sajmo0n/Time_Sampling_Oscilloscope/Project Outputs for Time_Sampling_Oscilloscope/BOM/Bill of Materials-Time_Sampling_Oscilloscope(Basic Assembly).xlsx

Description | Designator | Footprint | LibRef | Quantity | MPN
Non-polarised capacitor | C1_1, C1_2, C4_1, C4_2, C11, C26, C29, C33 | CAPC0603X90N | CC0603_1UF_16V_10%_X7R | 8 | CL10B105KO8NNNC
Non-polarised capacitor | C2_1, C2_2, C5_1, C5_2, C8, C9, C13, C15, C18, C19, C22, C23, C27, C28, C31, C32, C34, C35_1, C35_2, C36_1, C36_2, C37_1, C37_2, C38_1, C38_2, C40 | CAPC0603X90N | CC0603_100NF_16V_10%_X7R | 26 | VJ0603Y104KXJCW1BC
Non-polarised capacitor | C3_1, C3_2, C6_1, C6_2 | CAPC0603X90N | CC0603_100PF_50V_5%_X7R | 4 | 06035C101JAT2A
Non-polarised capacitor | C7, C10, C12, C16, C17, C20 | CAPC0603X90N | CC0603_2U2F_16V_10%_X7R | 6 | GRM188Z71C225KE43D
Non-polarised capacitor | C21, C24 | CAPC0603X90N | CC0603_4U7F_16V_10%_X7R | 2 | GRM188Z71C475KE21D
Non-polarised capacitor | C30 | CAPC0603X90N | CC0603_10UF_25V_10%_X7R | 1 | GRM188R61E106KA73D
Fuse; Very Fast Acting; 1.5A; 125VAC, 63VDC; SMD; | F1 | FUSE1206 | C1Q 1 | 1 | C1Q 1.5
Coaxial Connectors SMA, Edge Mount, Female Receptacle, 0.062" PCB Mount, Gold | J1, J2, J5, J6 | CONSMA020.062-G | CONSMA020.062-G | 4 | CONSMA020.062-G
Coaxial Connectors VERTICAL PCB JACK GOLD PLATED BRASS | J3_1, J3_2, J3_3, J4_1, J4_2, J4_3 | 901-144-8RFX | 901-144-8RFX | 6 | 901-144-8RFX
4mm Jack 90deg PCB Mounted Insulated Socket Red | J7 | 5710500-Deltron | 571-0500 | 1 | 571-0500
4mm Jack 90deg PCB Mounted Insulated Socket Black | J8 | 5710100-Deltron | 571-0100 | 1 | 571-0100
Ferrite Bead | L1_1, L1_2, L2_1, L2_2, L3, L4_1, L4_2, L5, L6_1, L6_2, L7_1, L7_2, L8 | INDC0603X90N | FB0603_120R@100MHZ_2A | 13 | BLM18PG121SN1D
SMD mono-color Chip LED, Green, 0603 | LD1, LD2, LD3, LD4 | LED_0603X60N | LED_0603_V_GREEN | 4 | HSME-C191
WR-PHD SMT Angled Dual Pin Header, 2.54mm, 2x6 | P2, P3 | WURTH_610112249121 | WURTH_610112249121 | 2 | WURTH_610112249121
General Purpose Thick Film Chip Resistor | R2_1, R22, R34_2 | RESC0402X40N | R0402_49R9_0.0625W_100PPM | 3 | RC0402FR-0749R9L
General Purpose Thick Film Chip Resistor | R5_1, R5_2, R6_1, R6_2, R21, R27, R35, R38, R40 | RESC0402X40N | R0402_0R_JUMPER | 9 | CRCW04020000Z0EDC
General Purpose Thick Film Chip Resistor | R12, R13, R14, R17, R18 | RESC0603X60N | R0603_27R_0.1W_100PPM | 5 | WF06P270JTL
General Purpose Thick Film Chip Resistor | R15, R16 | RESC0603X60N | R0603_10K_0.1W_100PPM | 2 | CQ03SAF1002T5E
General Purpose Thick Film Chip Resistor | R23 | RESC0603X60N | R0603_1K_0.1W_100PPM | 1 | CQ03SAF1001T5E
General Purpose Thick Film Chip Resistor | R24, R25, R26 | RESC0603X60N | R0603_100R_0.1W_100PPM | 3 | 0603SAF1000T5E
General Purpose Thick Film Chip Resistor | R28_1, R28_2, R30_1, R30_2 | RESC0603X60N | R0603_100k_0.1W_25PPM | 4 | RT0603BRD07100KL
General Purpose Thick Film Chip Resistor | R29_1, R29_2, R31_1, R31_2, R32_1, R32_2, R33_1, R33_2 | RESC0603X60N | R0603_10k_0.1W_25PPM | 8 | RT0603BRD0710KL
General Purpose Thick Film Chip Resistor | R43_1, R43_2, R43_3, R44_1, R44_2, R44_3, R48_1, R48_2, R48_3, R49_1, R49_2, R49_3 | RESC0402X40N | R0402_1R43_0.0625W_100PPM | 12 | CRCW04021R43FKED
General Purpose Thick Film Chip Resistor | R45_1, R45_2, R45_3, R50_1, R50_2, R50_3 | RESC0402X40N | R0402_845R_0.0625W_100PPM | 6 | RC0402FR-07845RL
General Purpose Thick Film Chip Resistor | R46_1, R46_2, R46_3, R51_1, R51_2, R51_3 | RESC0402X40N | R0402_53R6_0.0625W_100PPM | 6 | RC0402FR-0753R6L
30V P-Channel MOSFET | T1 | SOT23-3 | AO3401A | 1 | AO3401A
Transistor: N-MOSFET; unipolar; 30V; 2.9A; 0.9W; SOT23 | T2, T3 | SOT23-3 | AO3406 | 2 | AO3406
Signal Conditioning 50 ohm 2 terminal Power Splitter | U1 | PS1608GT2R50T1 | PS1608GT2-R50-T1 | 1 | PS1608GT2-R50-T1
225-ps High-Speed Comparator with LVDS Outputs | U2_1, U2_2 | WSON50P200X200X80-9N | TLV3801 | 2 | TLV3801DSG
Ultralow Noise, 200 mA Linear Regulator, 2.5V out | U3 | SOT23-5 | ADM7160AUJZ-2.5 | 1 | ADM7160AUJZ-2.5
Switched Capacitor Inverter, Input Voltage: 2.7 V to 5.5 V, 200-mA Output Current | U4 | SOT23-6 | LM2776 | 1 | LM2776DBV
LDO Voltage Regulators -30V, 200mA, low noise, Linear Reg, 2.5V | U5 | SOT23-5 | ADP7182AUJZ-2.5 | 1 | ADP7182AUJZ-2.5
AD5623RBRMZ-3, Dual 12-/14-/16-Bit nanoDAC with 5 ppm/°C On-Chip Reference, 10-Pin MSOP | U6 | MSOP50P490X110-10N | AD5623RBRMZ-3 | 1 | AD5623RBRMZ-3
3.3V, 500 mA, Ultralow Noise, High PSRR,Fast Transient Response CMOS LDO, FIXED, LFCSP-8 | U7 | LFCSP50P300X300X80-9N-D | ADM7170ACPZ-3.3 | 1 | ADM7170ACPZ-3.3-R7
Precision Low Drift Low Noise Buffered Reference | U8 | MSOP65P490X110-8N | LTC6652BHMS8-1.25 | 1 | LTC6652BHMS8-1.25#PBF
SINGLE INVERTER GATE | U9 | SOT23-5 | SN74LVC1G04MDBVREP | 1 | SN74LVC1G04MDBVREP
VS = 1.8 V (±0.9 V) up to 5.5 V (±2.75 V), 350kHz, 2-?V VOS, 0.02-?V/°C, 17-?A, , Zero-Drift Series | U10_1, U10_2, U11_1, U11_2 | SOT23-5 | TLV333IDBV | 4 | TLV333IDBV
ADN4661BRZ, Single, 3 V, CMOS, LVDS, High Speed Differential Driver | U12 | SOIC-8 | ADN4661BRZ | 1 | ADN4661BRZ
Overvoltage Protection Controller, 2.5V to 5.5V Operation, Reverse Voltage Protection | U13 | SC70-8 | LTC4360ISC8-2 | 1 | LTC4360ISC8-2#TRMPBF
