sajmo0n/Time_Sampling_Oscilloscope/Project Outputs for Time_Sampling_Oscilloscope/SCHEMATICS/Time_Sampling_Oscilloscope.PDF

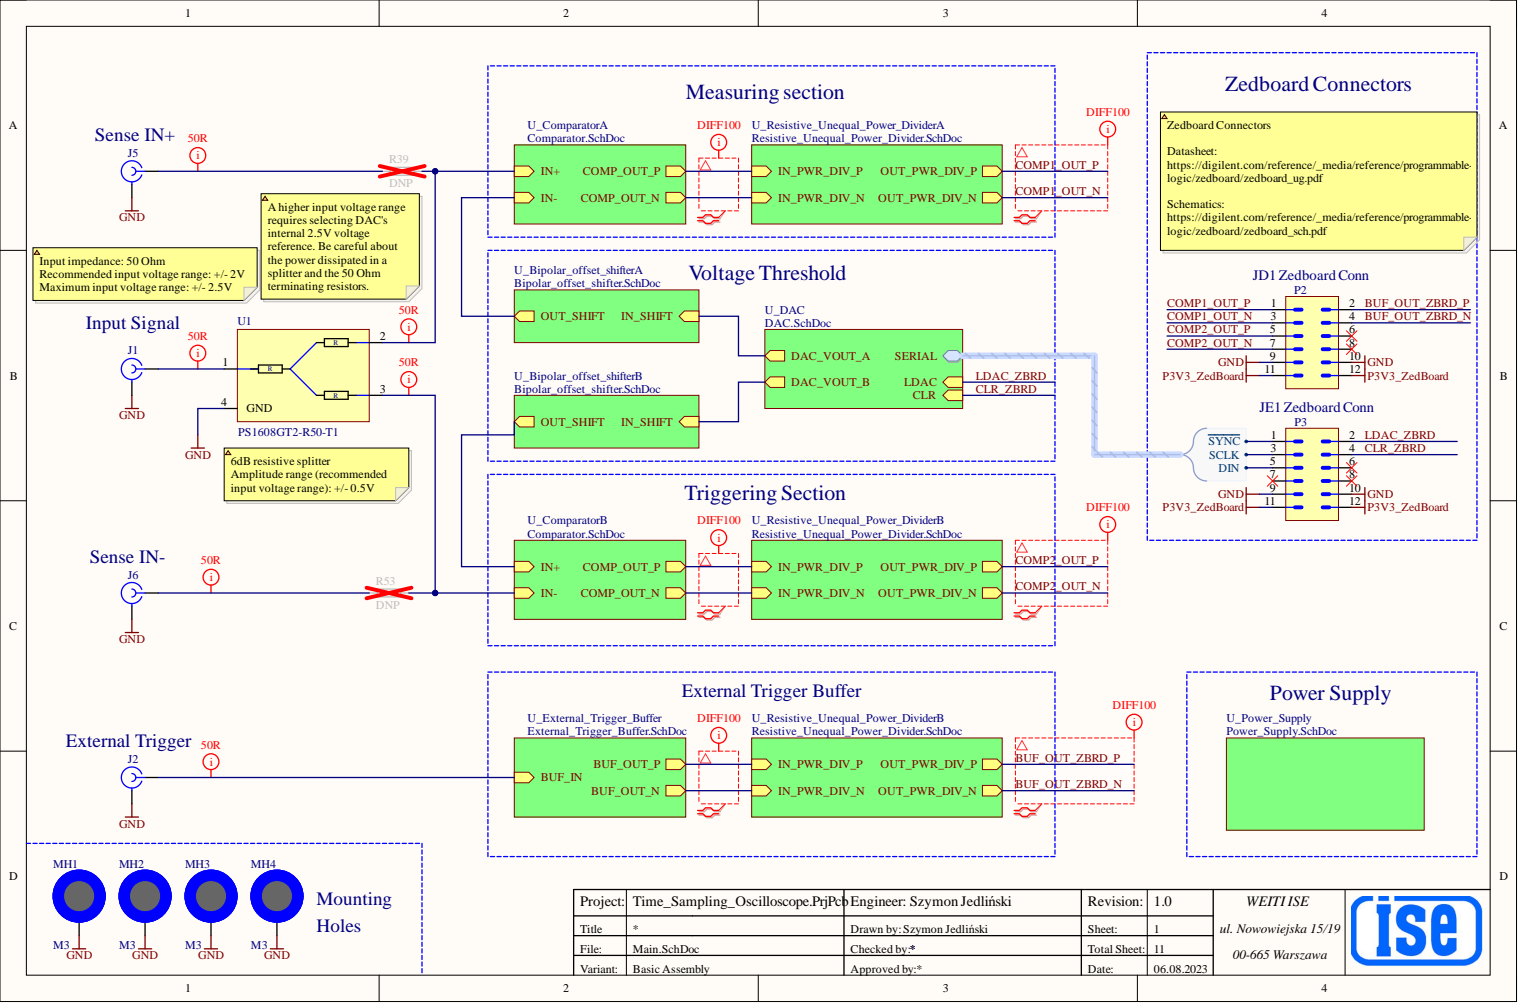
[picture p1: page 1]

T i tl e | * | Draw n Szymo Jed ń ki | Sheet
Fi : | Mai n.Sch D o c | Checked | To tal Sheet

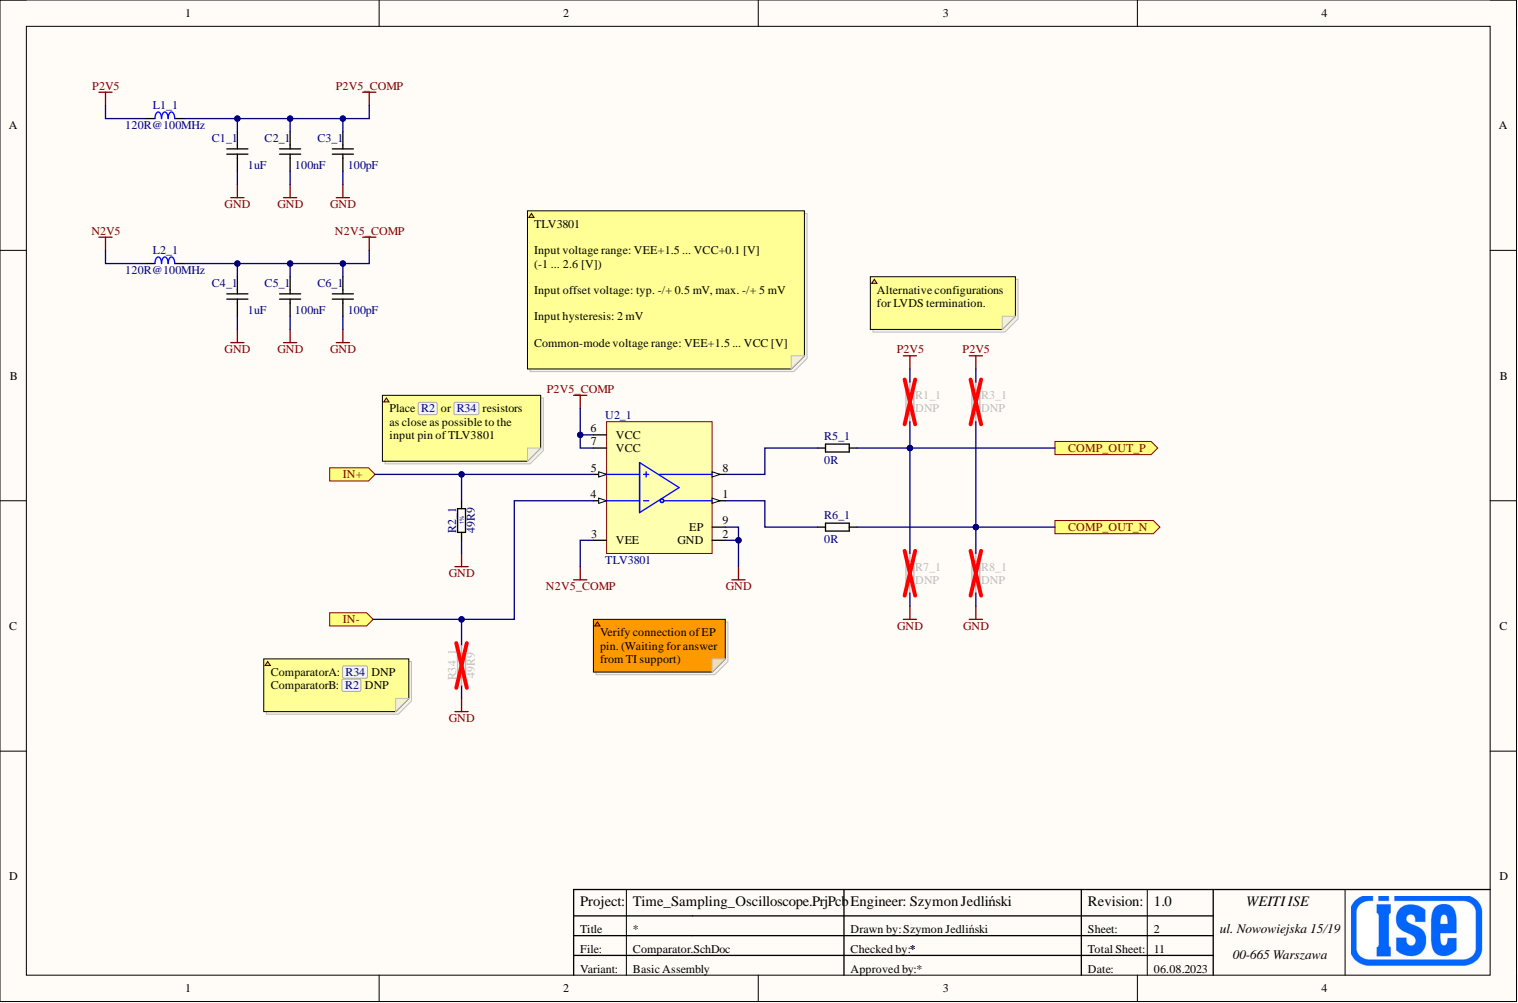
[picture p2: page 2]

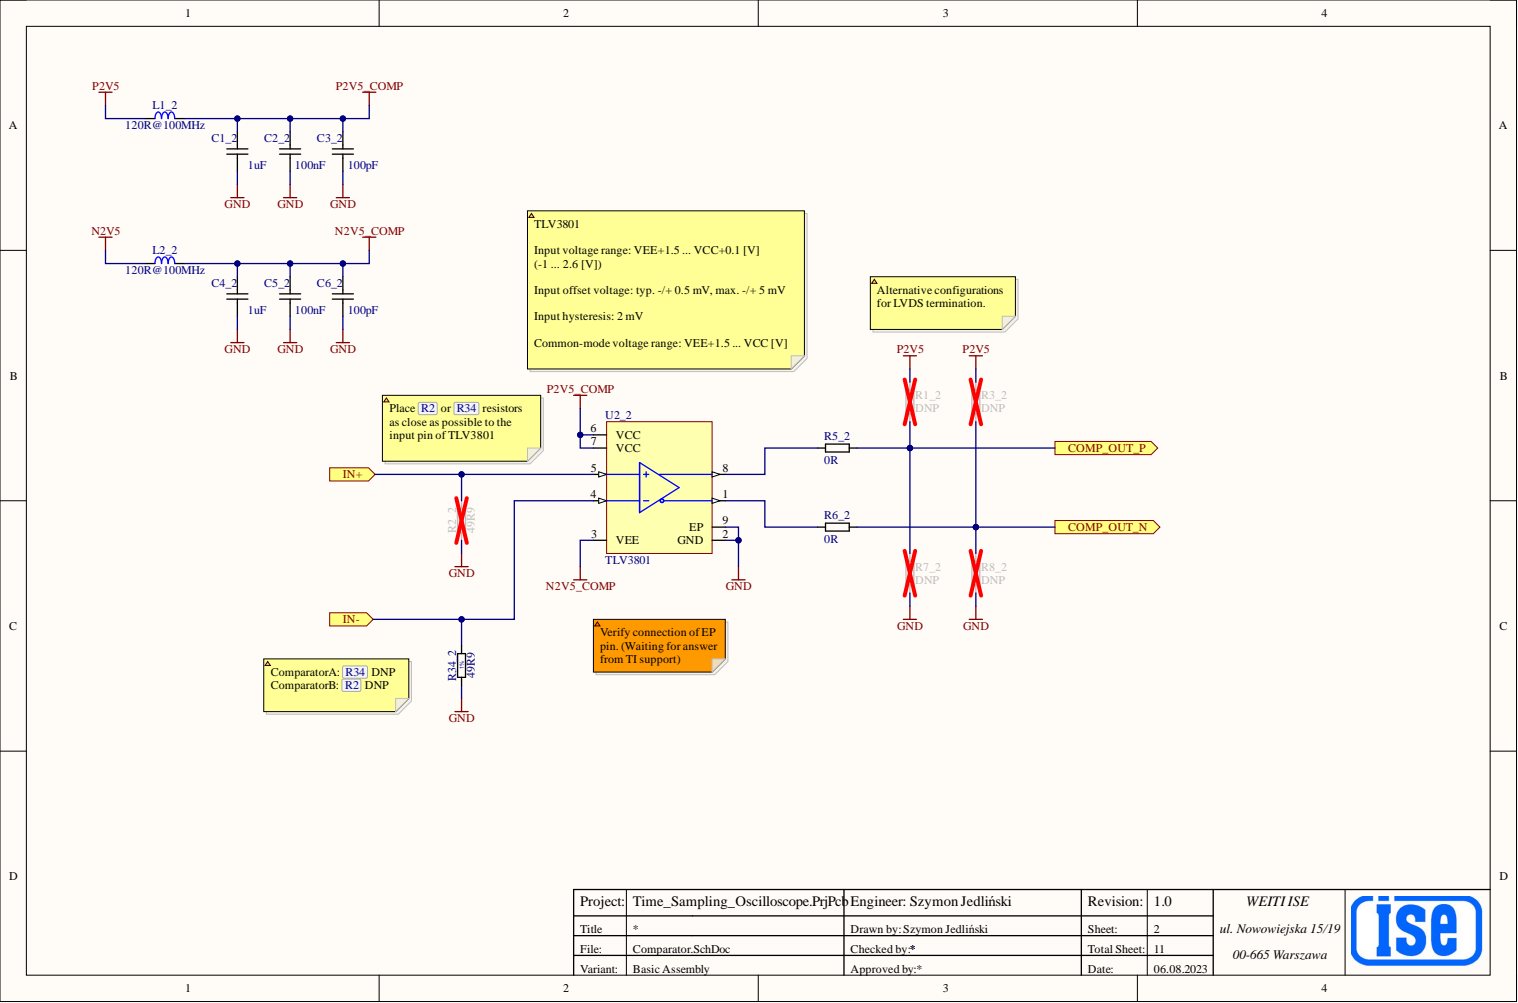
[picture p3: page 3]

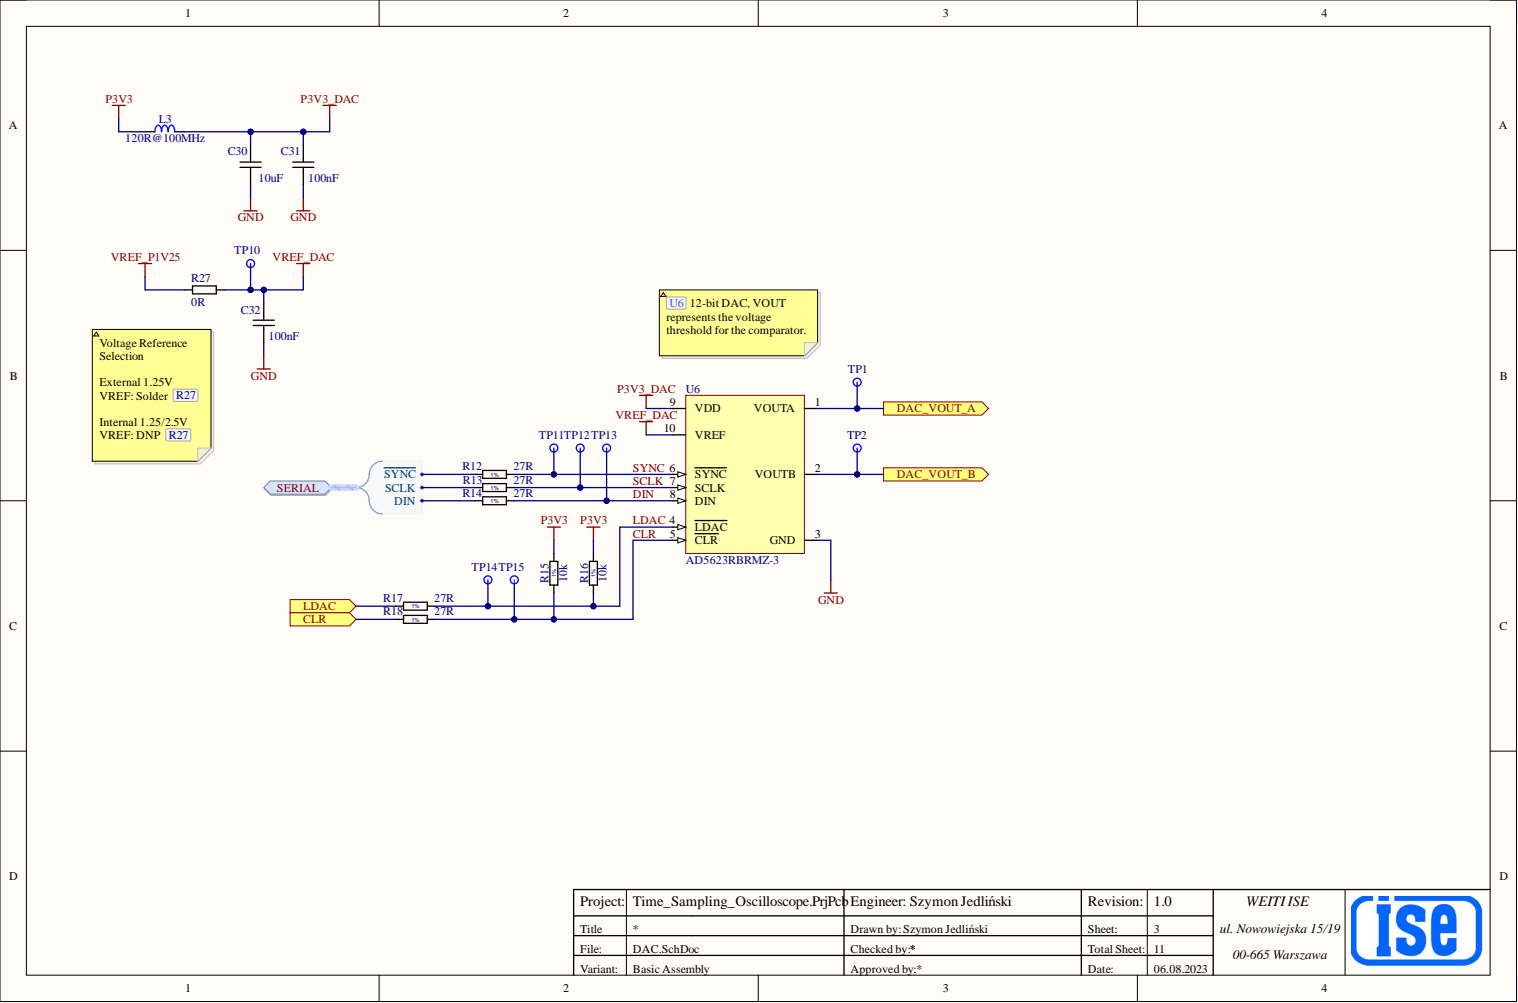
[picture p4: page 4]

U6 12-bit DAC, VOUT
represents the voltage
threshold for the comparator.

1% | SCLK | DIN 8 SCLK 7 SYNC 6

1% | DIN

Title | | Drawn by: Szymon Jedliński | Sheet:
File: | DAC.SchDoc | Checked by: | Total Sheet:

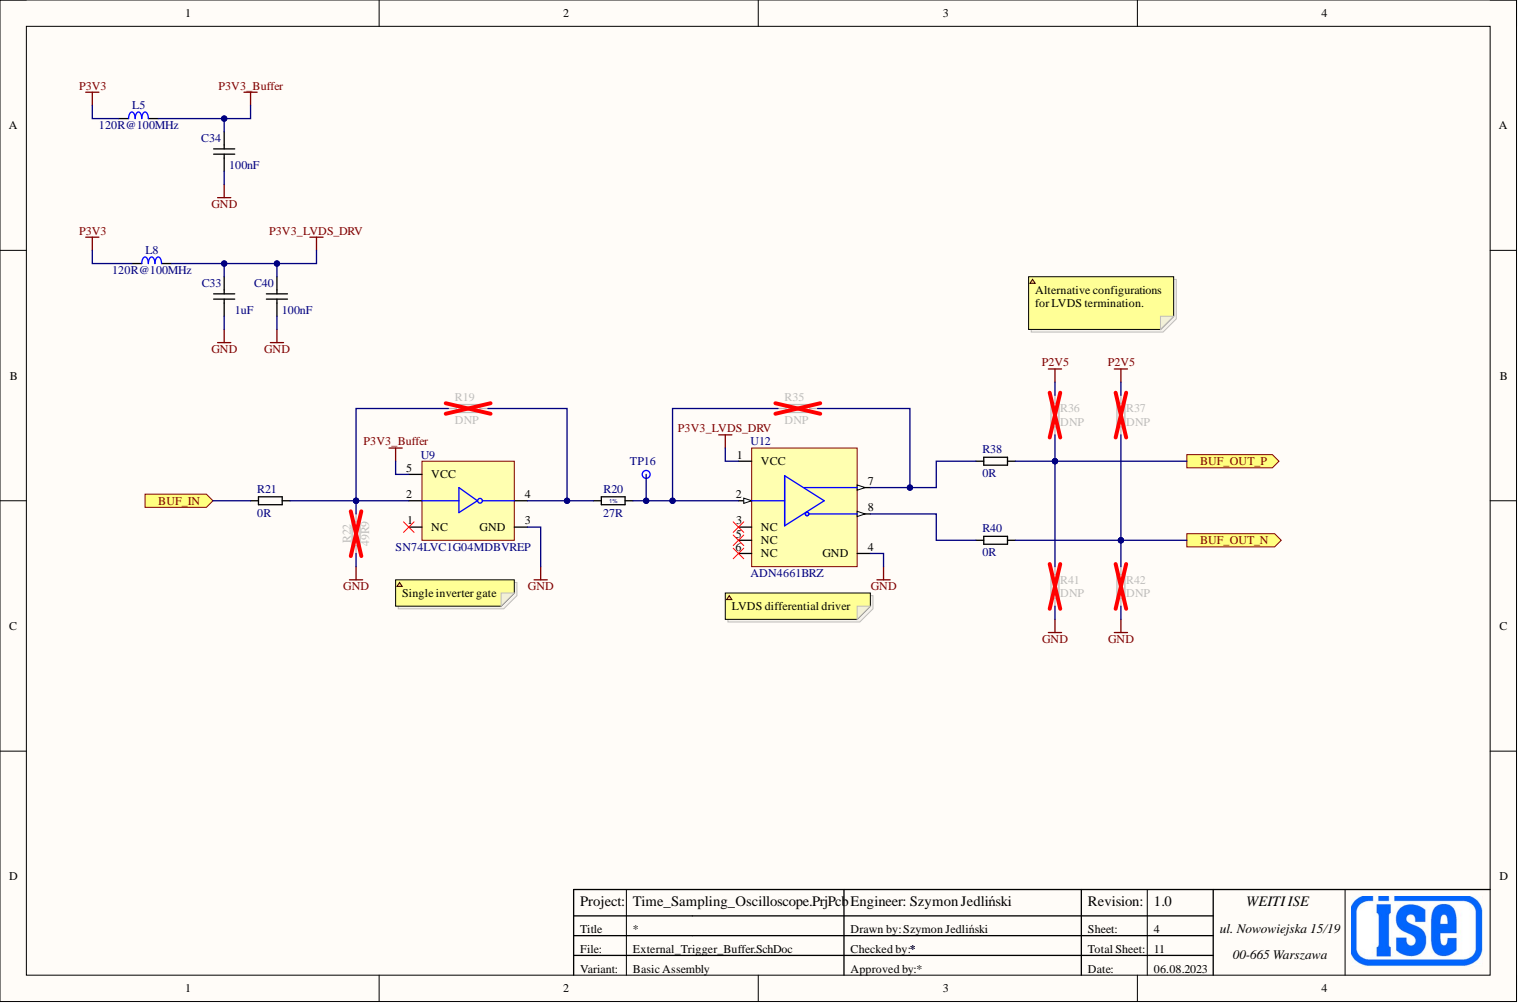
[picture p5: page 5]

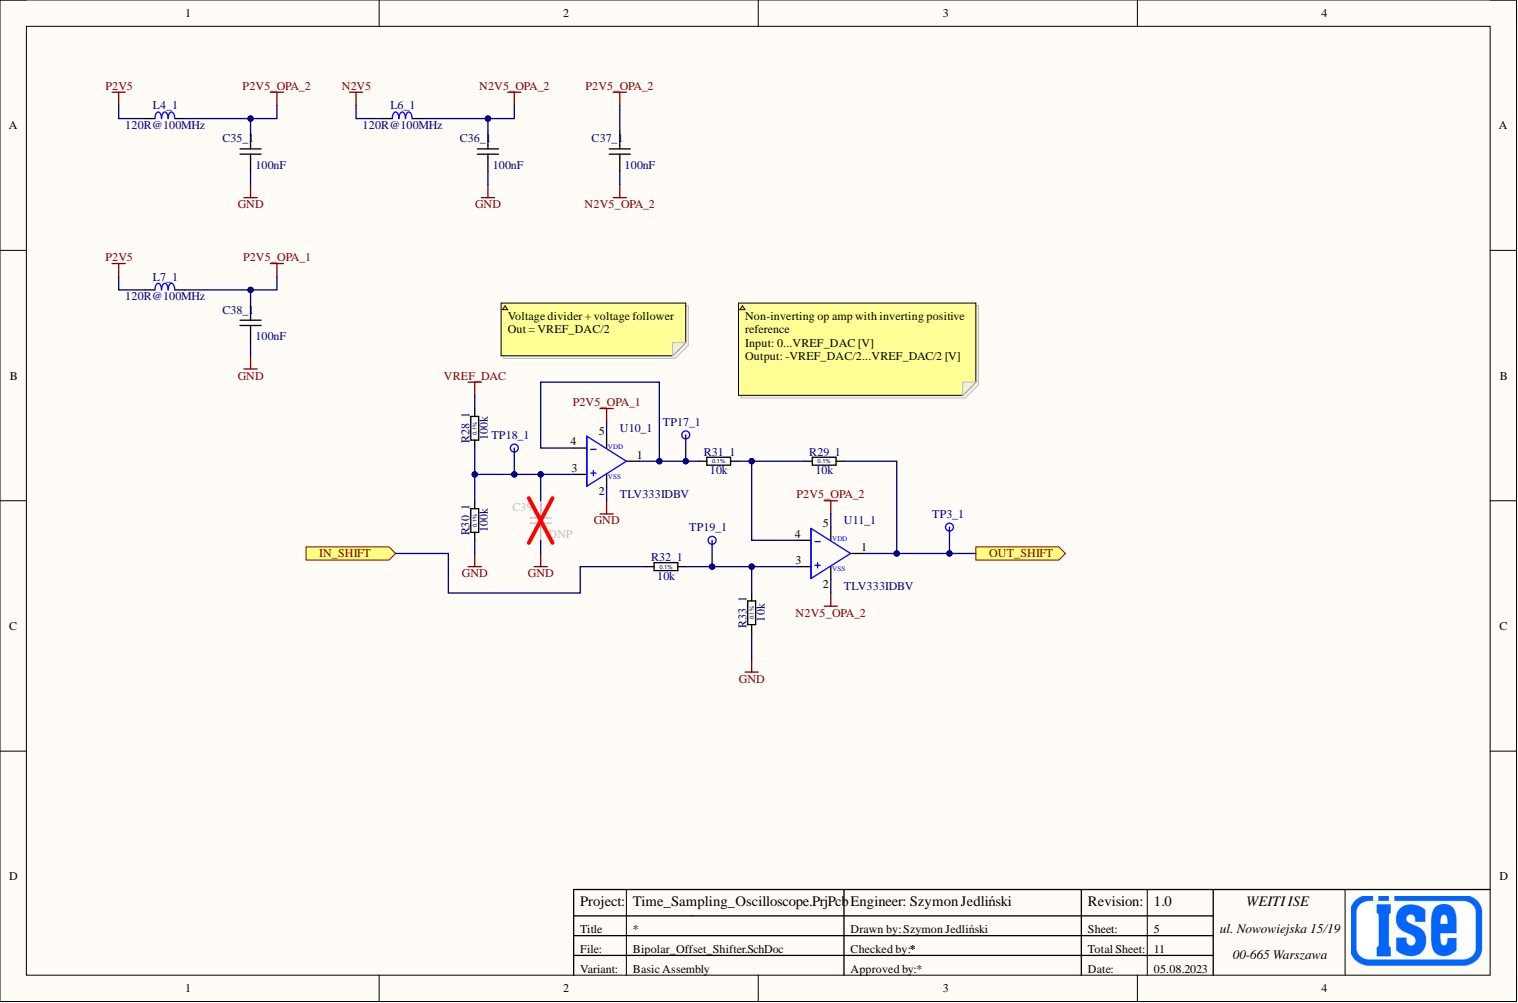
[picture p6: page 6]

Voltage divider + voltage follower
Out = VREF_DAC/2

Non-inverting op amp with inverting positive
reference
Input: 0...VREF_DAC [V]
Output: -VREF_DAC/2...VREF_DAC/2 [V]

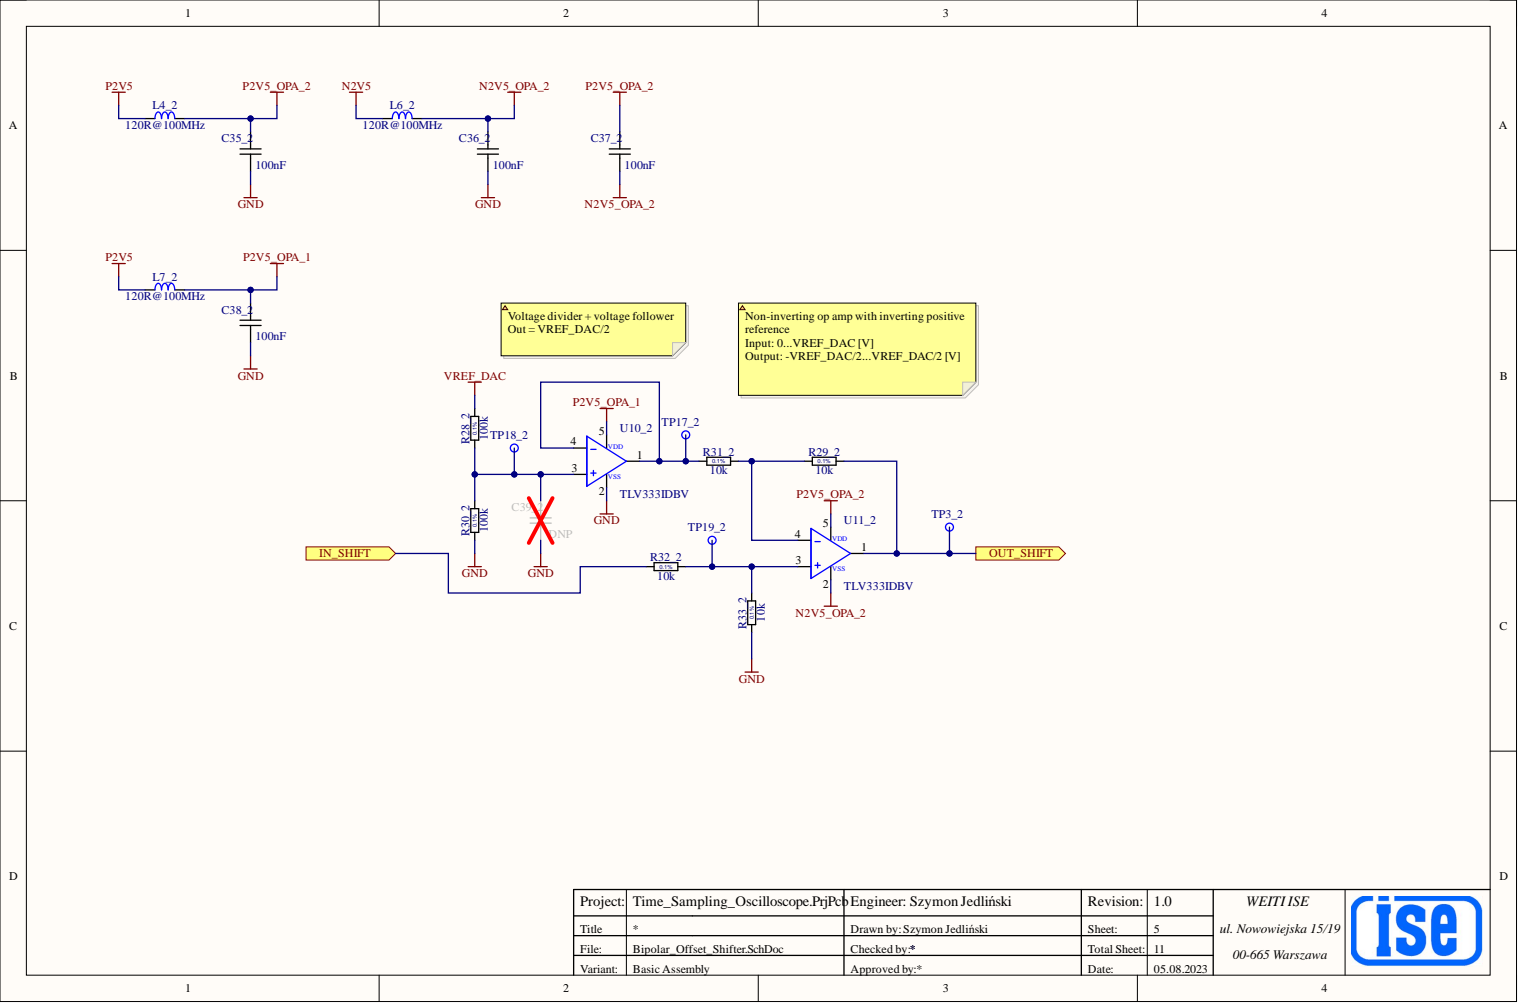
[picture p7: page 7]

Voltage divider + voltage follower
Out = VREF_DAC/2

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

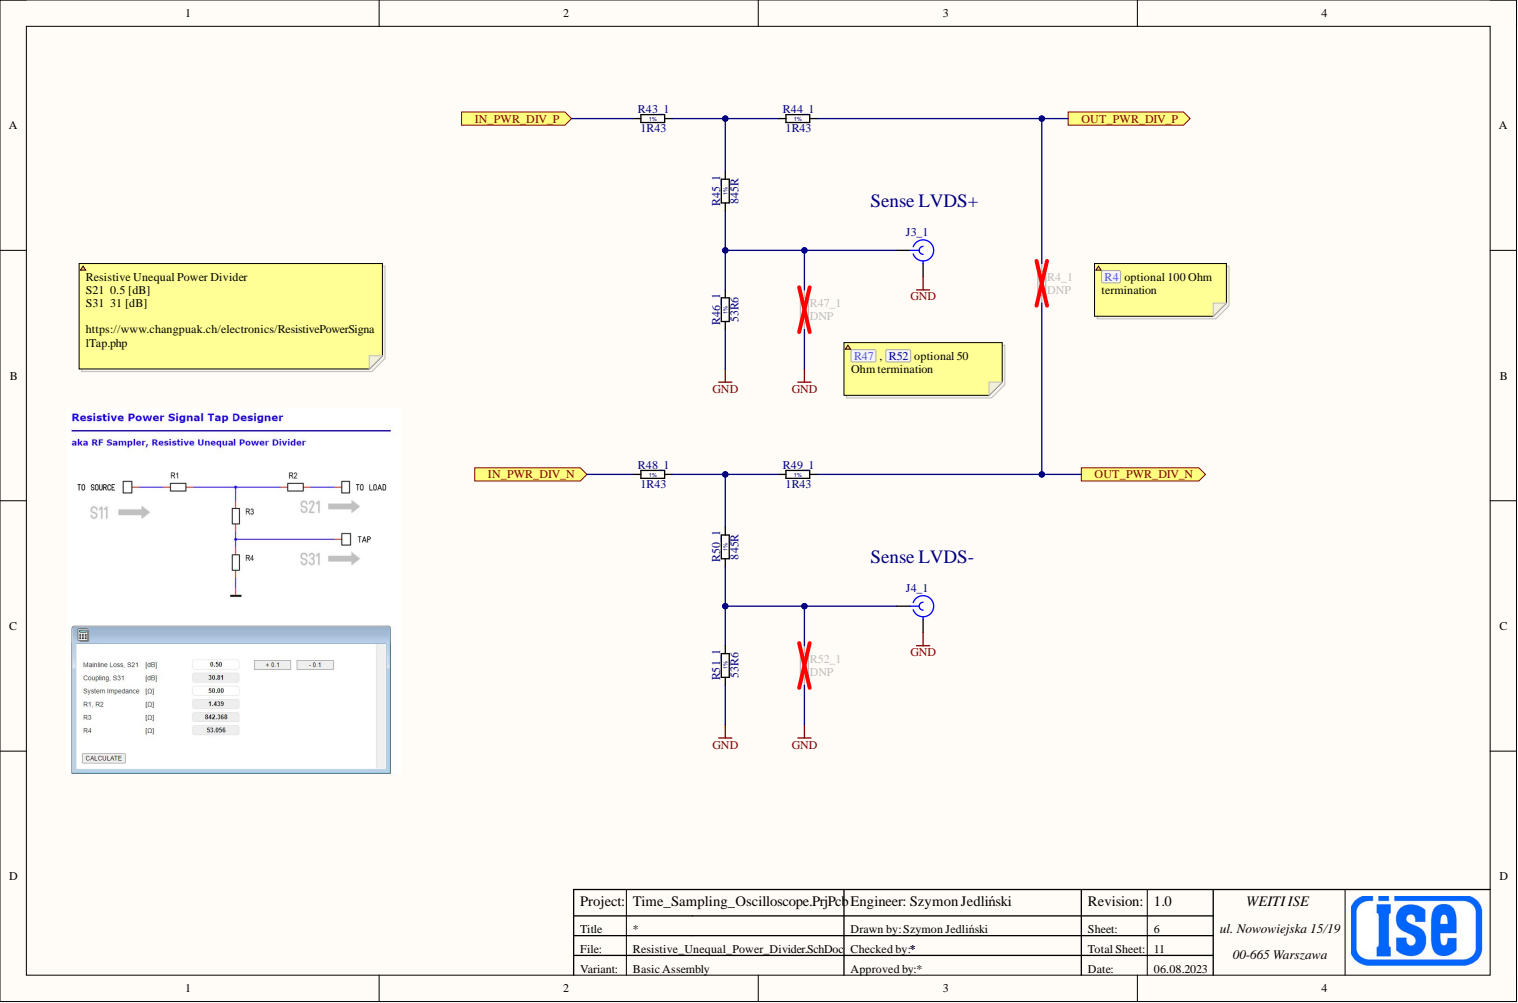
[picture p8: page 8]

Resistive Unequal Power Divider

https://www.changpuak.ch/electronics/ResistivePowerSigna
lTap.php

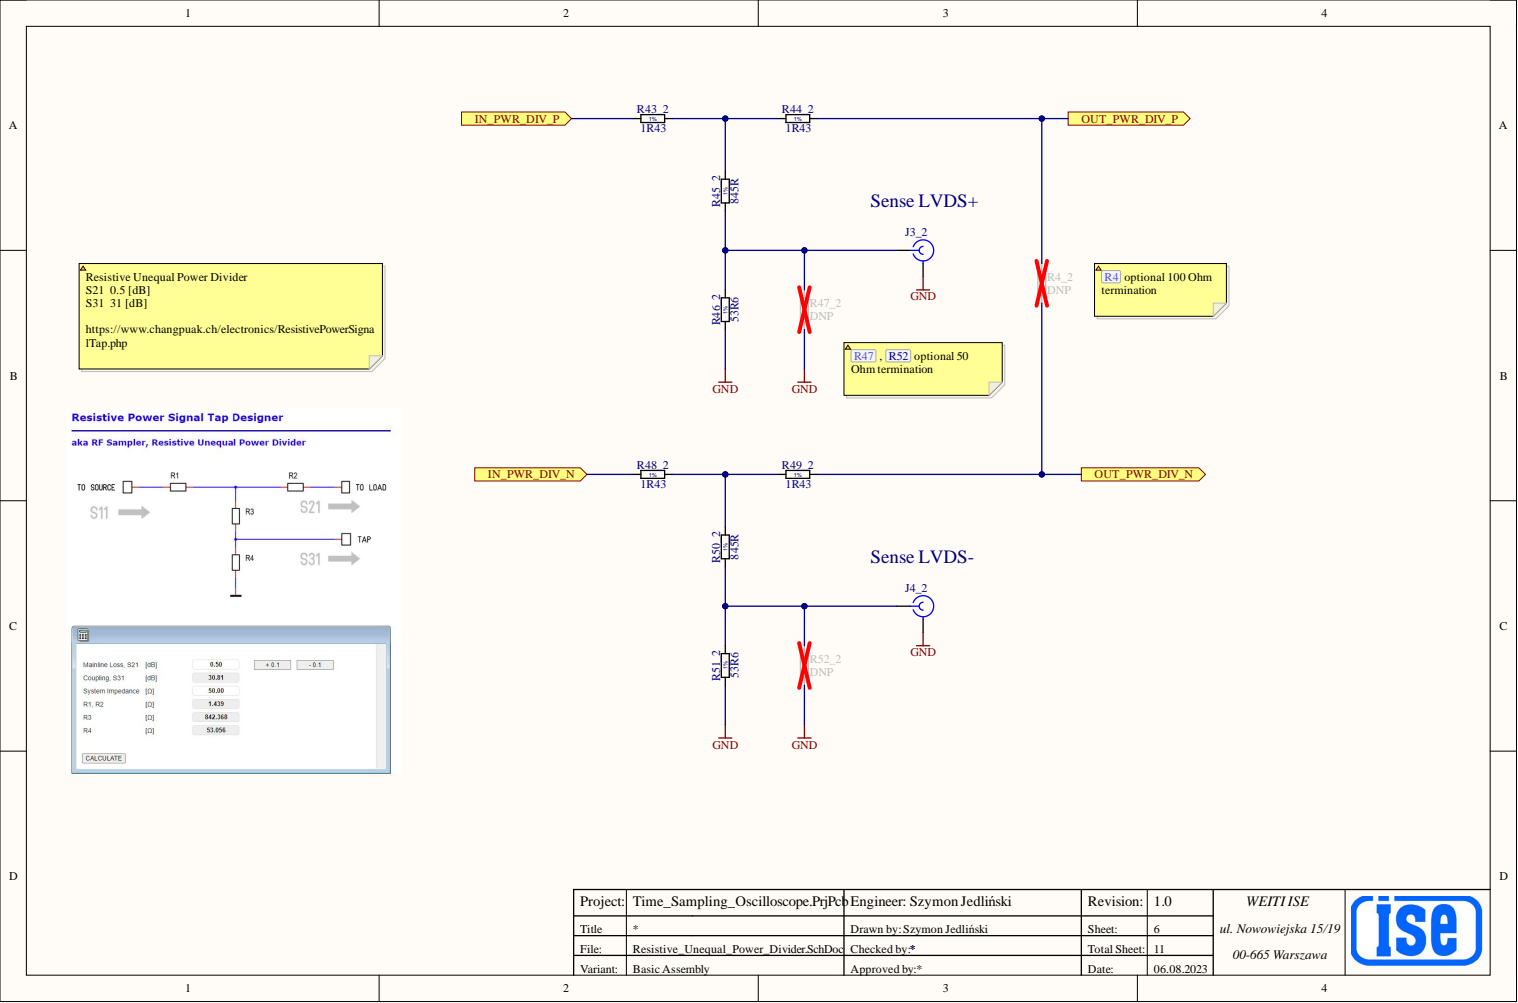
[picture p9: page 9]

Resistive Unequal Power Divider

https://www.changpuak.ch/electronics/ResistivePowerSigna
lTap.php

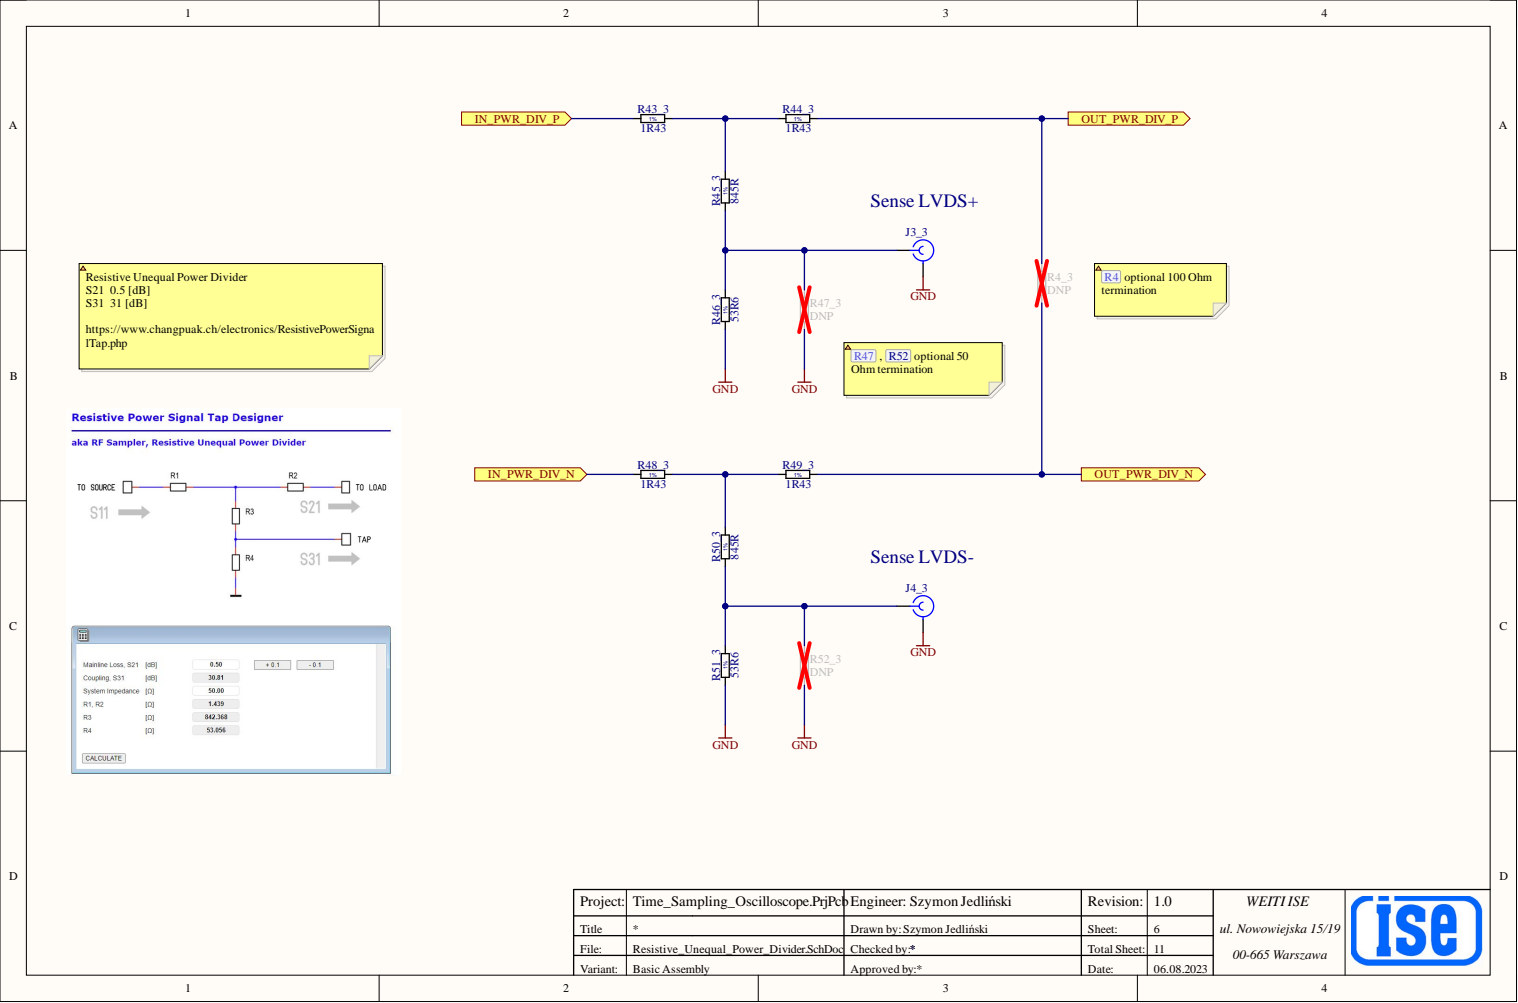
[picture p10: page 10]

Resistive Unequal Power Divider

https://www.changpuak.ch/electronics/ResistivePowerSigna
lTap.php

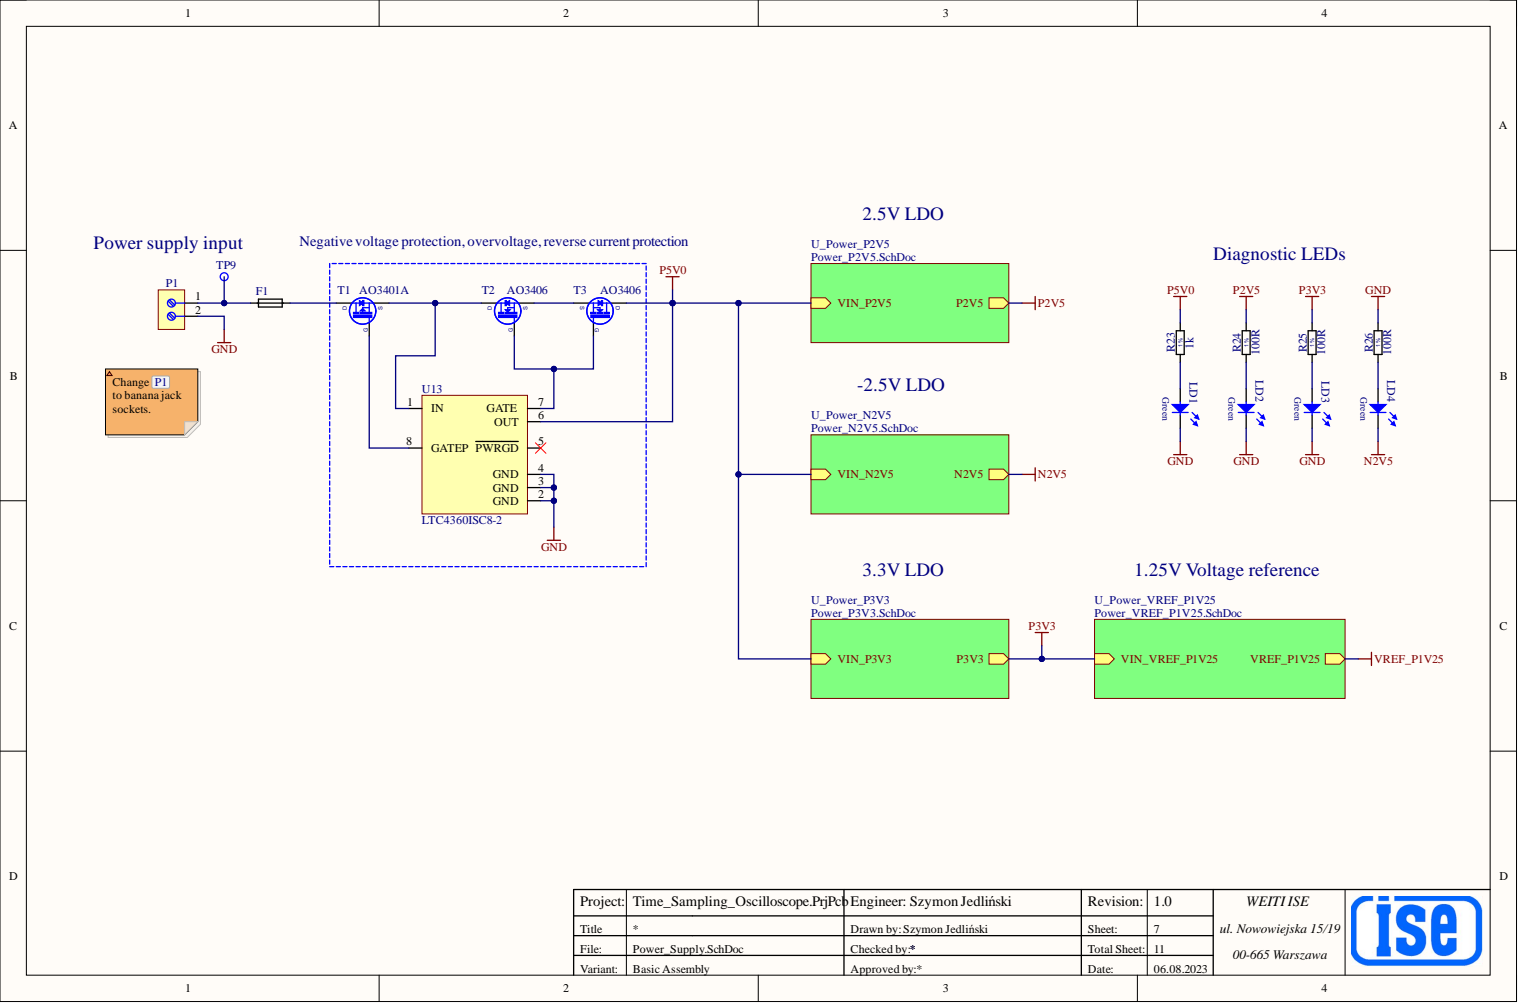
[picture p11: page 11]

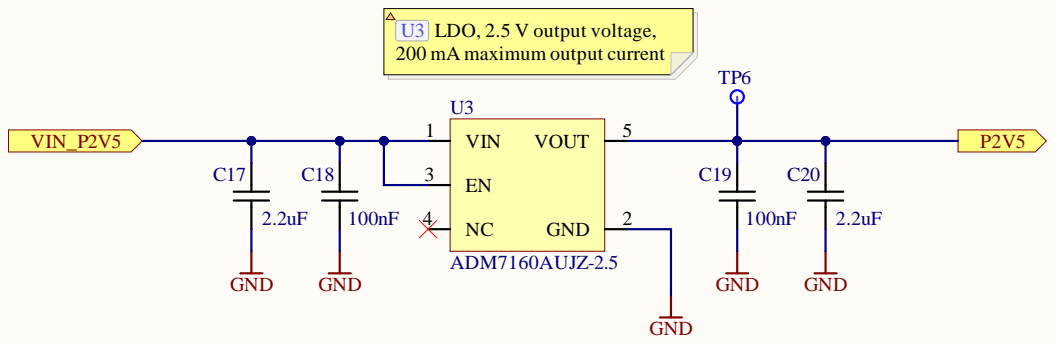
[picture p12: page 12]

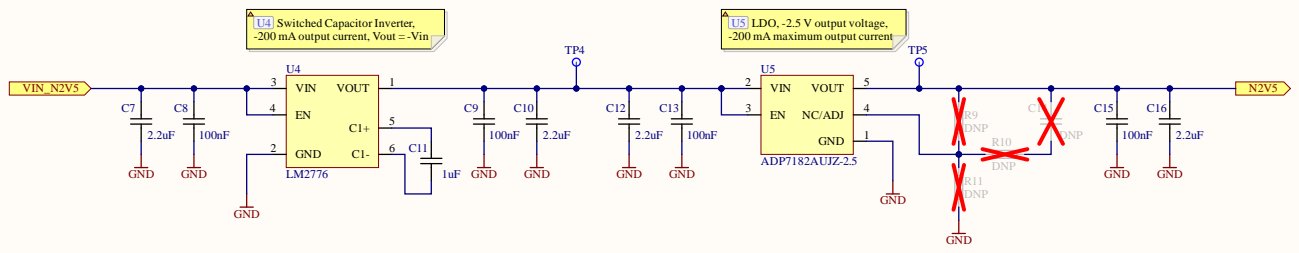
[picture p13: page 13]

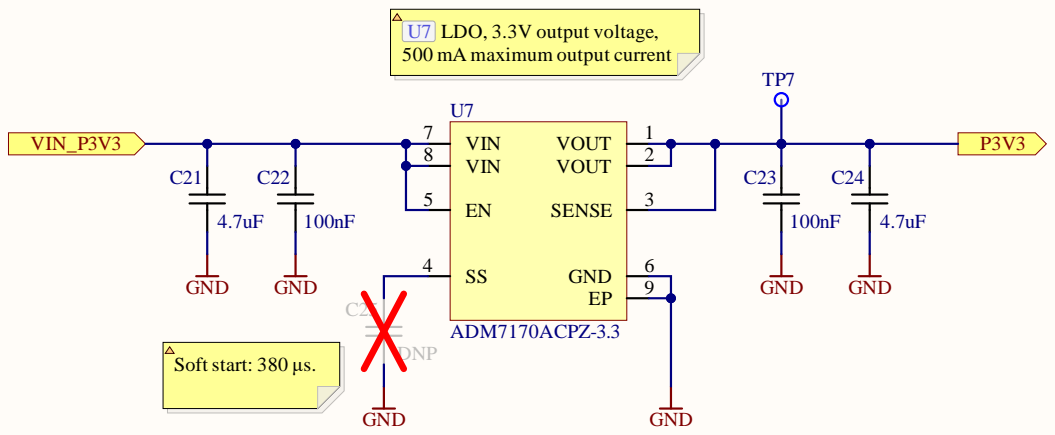
[picture p14: page 14]

U7 LDO, 3.3V output voltage,
500 mA maximum output current

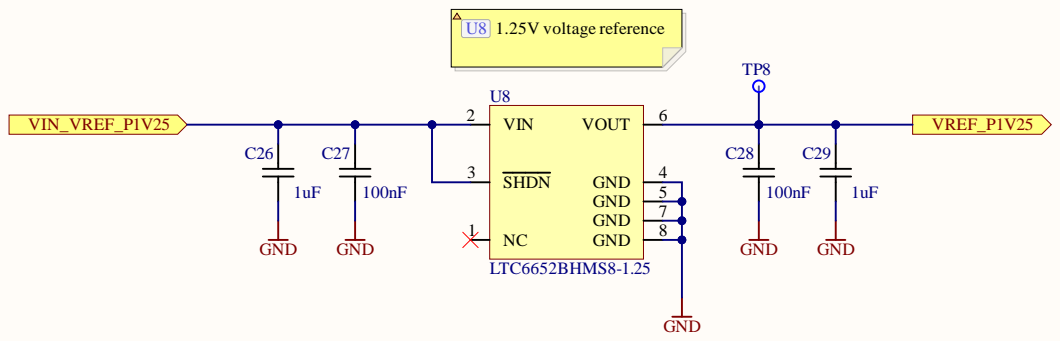
[picture p15: page 15]
