sajmo0n/Time_Sampling_Oscilloscope/Project Outputs for Time_Sampling_Oscilloscope/ASSEMBLY/Time_Sampling_Oscilloscope.PDF

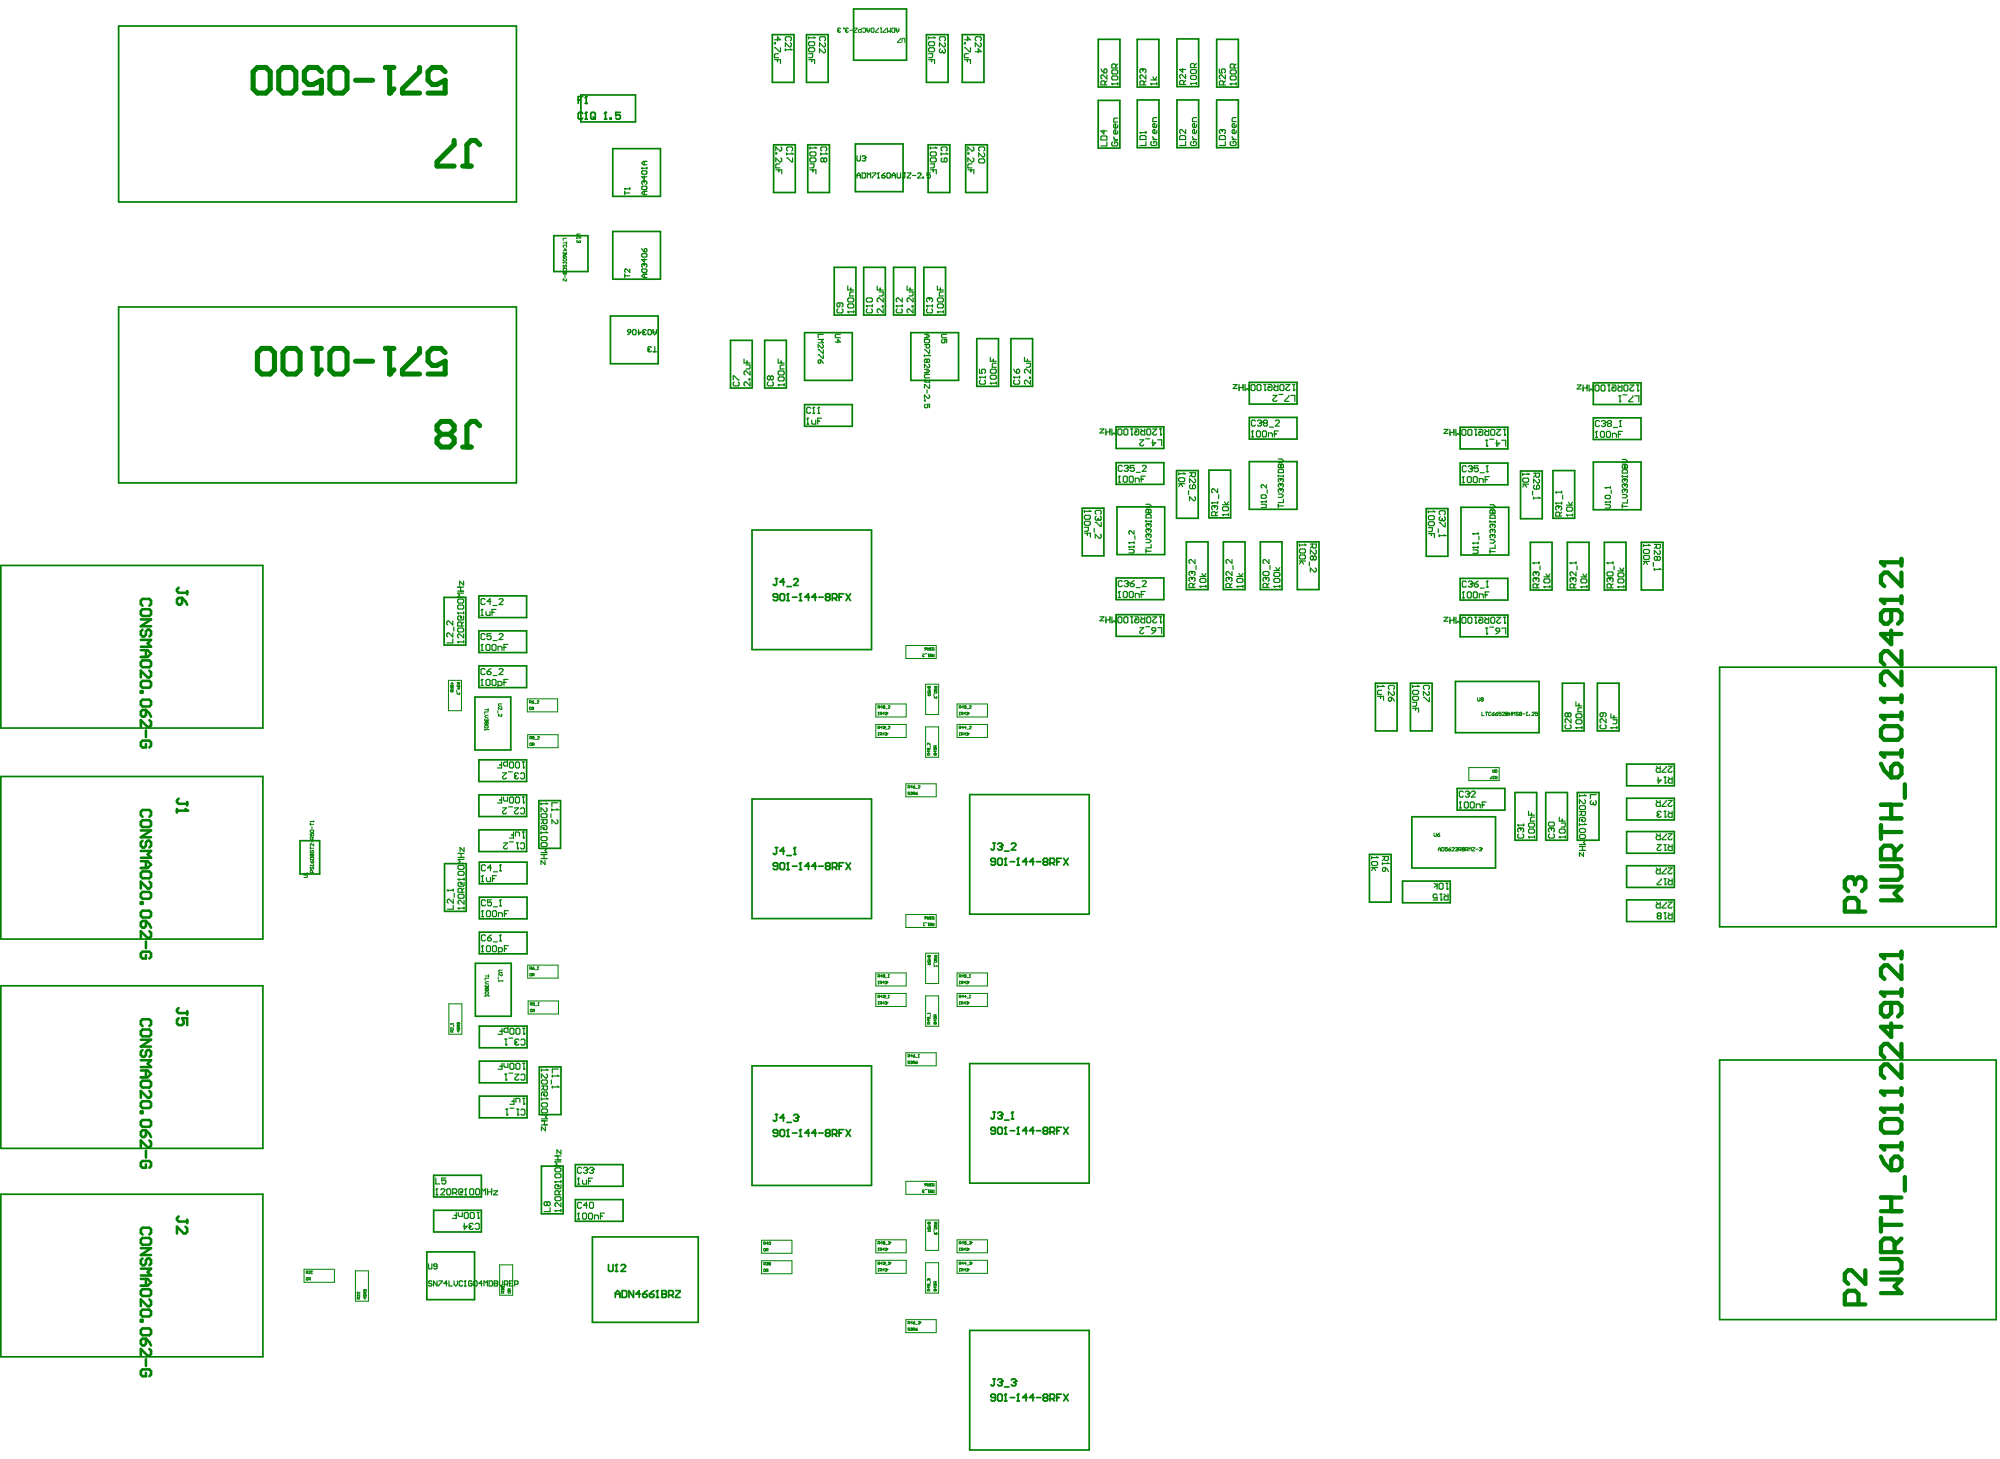
[picture p16: page 1]

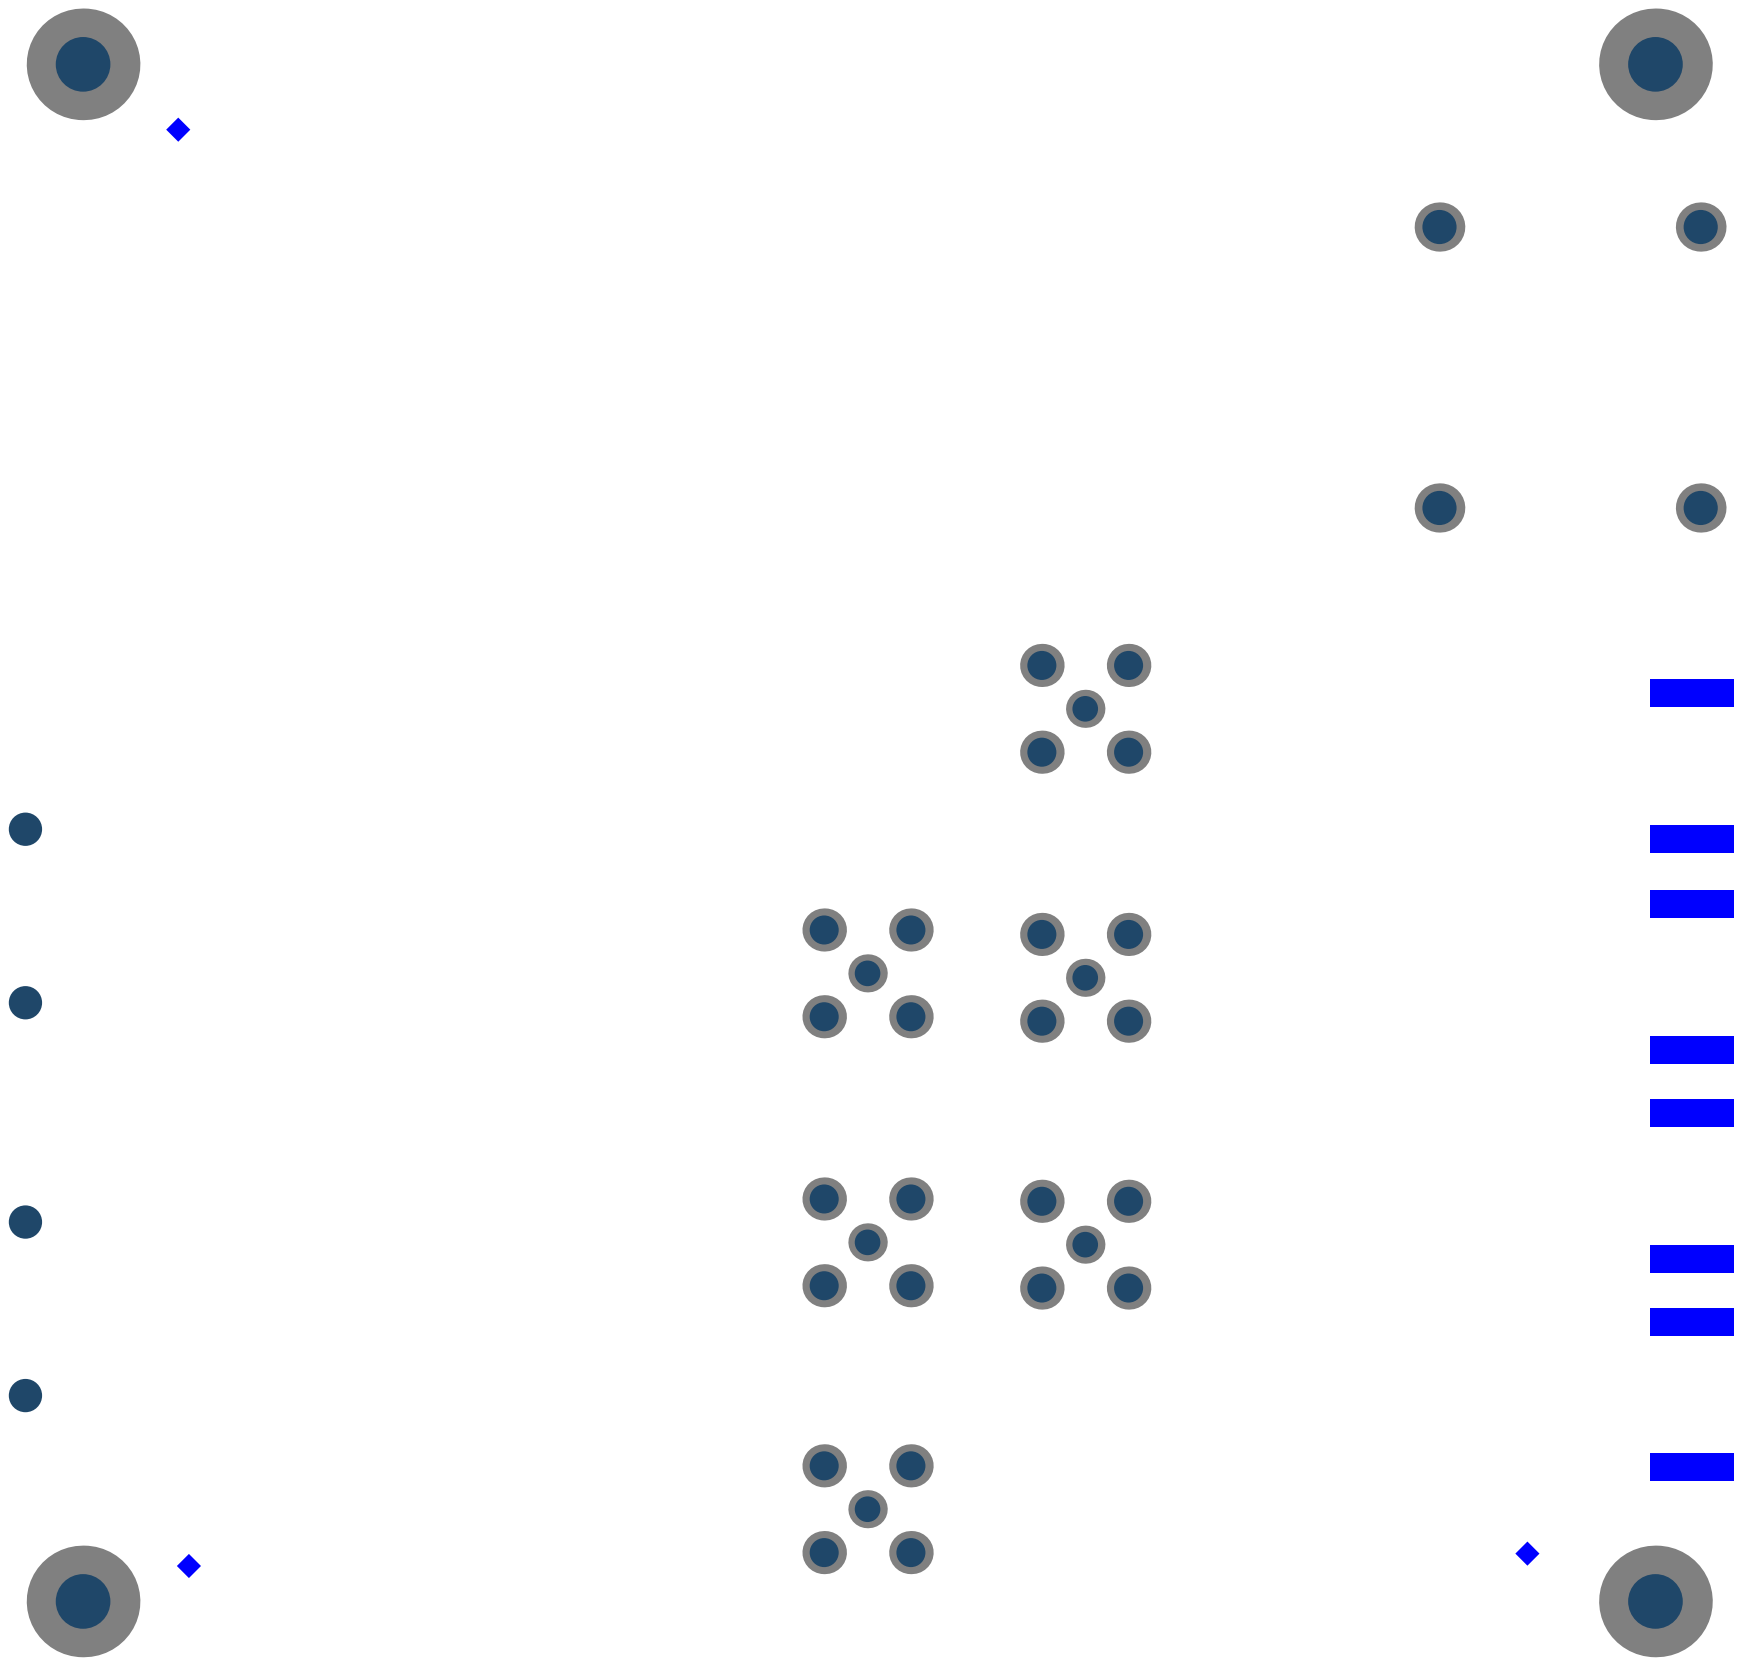
[picture p17: page 2]
