sajmo0n/Time_Sampling_Oscilloscope/(list of files, drawings)

Other design files:
PCB.PcbDoc
Schematics/Bipolar_Offset_Shifter.SchDoc
Schematics/Comparator.SchDoc
Schematics/DAC.SchDoc
Schematics/External_Trigger_Buffer.SchDoc
Schematics/Main.SchDoc
Schematics/Power_N2V5.SchDoc
Schematics/Power_P2V5.SchDoc
Schematics/Power_P3V3.SchDoc
Schematics/Power_Supply.SchDoc
Schematics/Power_VREF_P1V25.SchDoc
Schematics/Resistive_Unequal_Power_Divider.SchDoc
Time_Sampling_Oscilloscope.PrjPcb
