sajmo0n/Time_Sampling_Oscilloscope/(commit log)

2023-07-29 1# 29.07.2023
    1# 29.07.2023
    LVDS termination - alternative configurations
    Improvements in comparator circuit
    [Comparator_circuit.SchDoc, TOP.SchDoc, Time_Sampling_Oscilloscope.PrjPcb]
2023-07-29 2# 29.07.2023
    - added power supply components 2V5
    - small changes in comparator circuit
    [Comparator_circuit.SchDoc, Power_Supply.SchDoc, TOP.SchDoc, Time_Sampling_Oscilloscope.PrjPcb]
2023-07-30 Power supply update
    Added P2V5 and N2V5 supplies
    [Power_N2V5.SchDoc, Power_P2V5.SchDoc, Power_Supply.SchDoc, Time_Sampling_Oscilloscope.PrjPcb]
2023-07-30 Project Update
    +3V3 supply,
    +VREF DAC 1.25V
    +DAC circuit
    +External trigger buffer
    +Supply LEDs
    +Connected all in main schematic
    [Comparator.SchDoc, Comparator_circuit.SchDoc, DAC.SchDoc, External_Trigger_Buffer.SchDoc, Main.SchDoc, Power_N2V5.SchDoc, Power_P2V5.SchDoc, Power_P3V3.SchDoc]
2023-08-04 Project Update 04.08.2023
    +bipolar offset shifter for dac output
    +50 Ohm impedance match for external trigger buffer
    +switched inputs in trigger section (optional test of comparator's symmetrical behaviour)
    +external trigger output switched to lvds
    +dac out measurement testpoints
    +resistive unequal power divider added to lvds outputs (comparators, external trigger buffer) - for testing purpose
    [Bipolar_Offset_Shifter.SchDoc, Comparator.SchDoc, DAC.SchDoc, External_Trigger_Buffer.SchDoc, Main.SchDoc, Power_N2V5.SchDoc, Resistive_Unequal_Power_Divider.SchDoc, Time_Sampling_Oscilloscope.PrjPcb]
2023-08-05 Cleanup of schematics
    Cleanup of schematics
    [Bipolar_Offset_Shifter.SchDoc, Comparator.SchDoc, DAC.SchDoc, External_Trigger_Buffer.SchDoc, Main.SchDoc, Power_N2V5.SchDoc, Power_P2V5.SchDoc, Power_P3V3.SchDoc]
2023-08-05 Project Update 06.08.2023
    +power supply protecting circuits
    +LEDs' resistors chosen properly
    +mounting holes
    +main schematic cleanup
    +sense connectors for measuring input signal
    +schematics pdf
    [Bipolar_Offset_Shifter.SchDoc, Comparator.SchDoc, DAC.SchDoc, External_Trigger_Buffer.SchDoc, Main.SchDoc, Power_N2V5.SchDoc, Power_P2V5.SchDoc, Power_P3V3.SchDoc]
2023-08-06 Project Update 06.08.2023 #2
    +all needed footprints
    +design updated - components on pcb
    [Comparator.SchDoc, DAC.SchDoc, External_Trigger_Buffer.SchDoc, Main.SchDoc, PCB.PcbDoc, PCB.pcbdoc, Power_N2V5.SchDoc, Power_P2V5.SchDoc]
2023-08-06 Project Update 06.08.2023 #3
    +pdf schematics updated
2023-08-12 Project Update 12.08.2023
    +banana jack pcn mounted connectors for power supply
    +verified signals connections to zedboard
    +some preliminary placement
    [Comparator.SchDoc, Main.SchDoc, Power_Supply.SchDoc, Time_Sampling_Oscilloscope.PrjPcb]
2023-08-13 Project Update 12.08.2023
    +fixed power splitter footprint
    +defined stackup -> 7C 1.55mm FR4 4L eurocircuits (1oz IL, EL, 0.36mm prepregs 7268)
    +preeliminary placement continued
    +changed edge sma to tht for sens outputs
    [DAC.SchDoc, External_Trigger_Buffer.SchDoc, Main.SchDoc, Power_N2V5.SchDoc, Power_P2V5.SchDoc, Power_P3V3.SchDoc, Power_Supply.SchDoc, Time_Sampling_Oscilloscope.PrjPcb]
2023-08-14 Project Update 14.08.2023
    Project Update 14.08.2023
    [Comparator.SchDoc, External_Trigger_Buffer.SchDoc, Main.SchDoc, Time_Sampling_Oscilloscope.PrjPcb]
2023-08-15 Project Update 15.08.2023
    PCB done, waiting for review
    [Bill of Materials-Time_Sampling_Oscilloscope(Basic Assembly).xlsx, Bipolar_Offset_Shifter.SchDoc, Comparator.SchDoc, Main.SchDoc, Resistive_Unequal_Power_Divider.SchDoc, Time_Sampling_Oscilloscope.PrjPcb]
2023-08-16 Project Update 16.08.2023
    +PCB width reduced from 105mm to 102mm
    +0.25mm Vias changed to 0.3mm hole diameter
    +moved 100 Ohm termination resistors close to zedboard connectors
    [Main.SchDoc, Time_Sampling_Oscilloscope.PrjPcb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]
2023-08-16 Project Update 16.08.2023
    [Main.SchDoc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]
2023-09-03 03.09.2023 Update
    -P&P
    [Pick Place for PCB(Basic Assembly).csv]
